avrovulcanxh607/vbit-pi3/vbit3.jpg

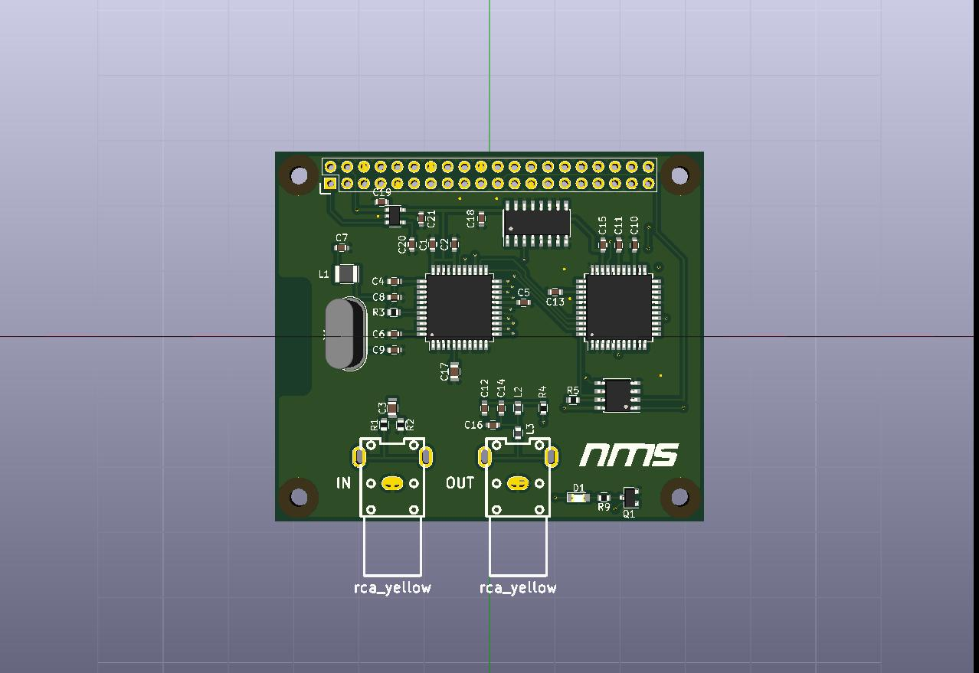
vbit3.jpg
