avrovulcanxh607/vbit-pi3/README.md

# vbit-pi3
Teletext inserter board for the Raspberry Pi

Code available at https://github.com/peterkvt80/vbit-py<br>
Instructions and other details available at https://www.nathanmediaservices.co.uk/vbit-pi/
