avrovulcanxh607/vbit-pi3/vbit3 side2.png

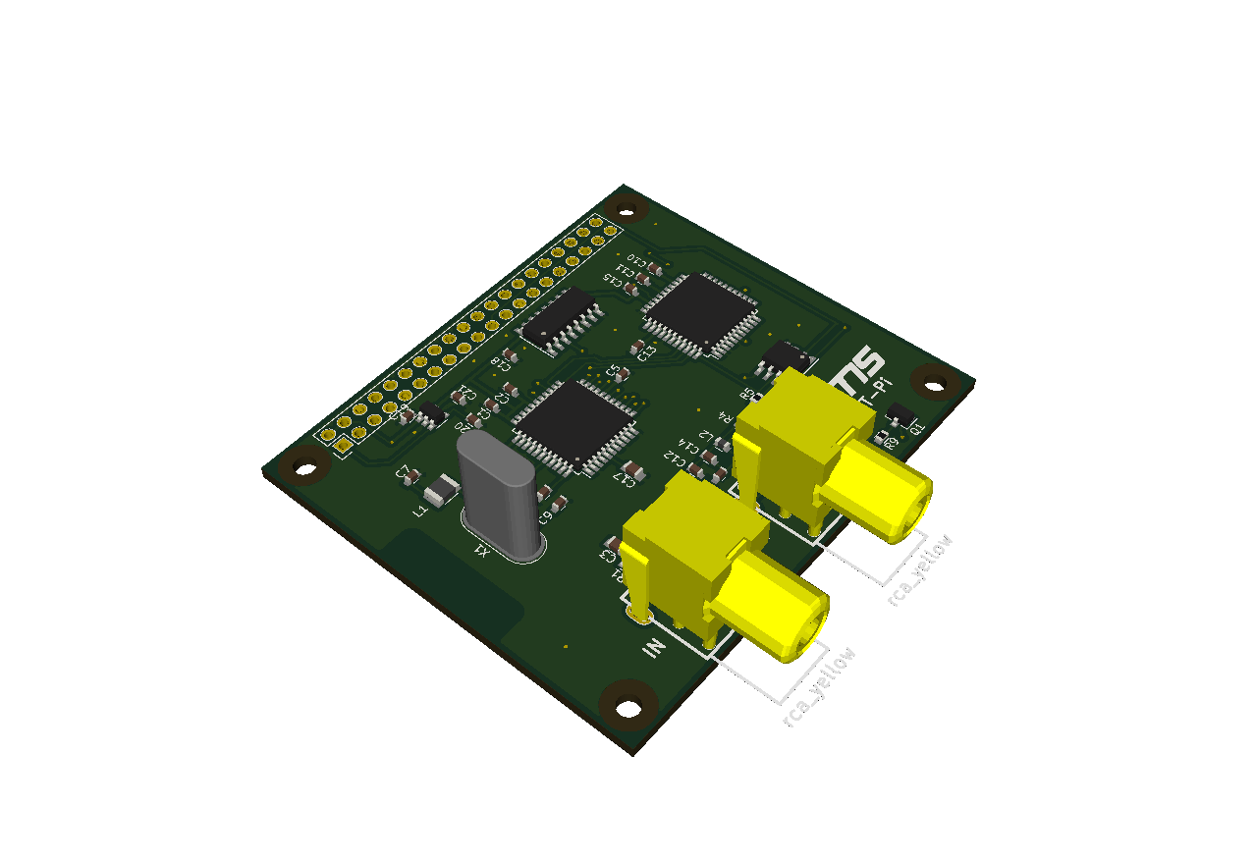
vbit3 side2.png
