avrovulcanxh607/vbit-pi3/vbit3 side.png

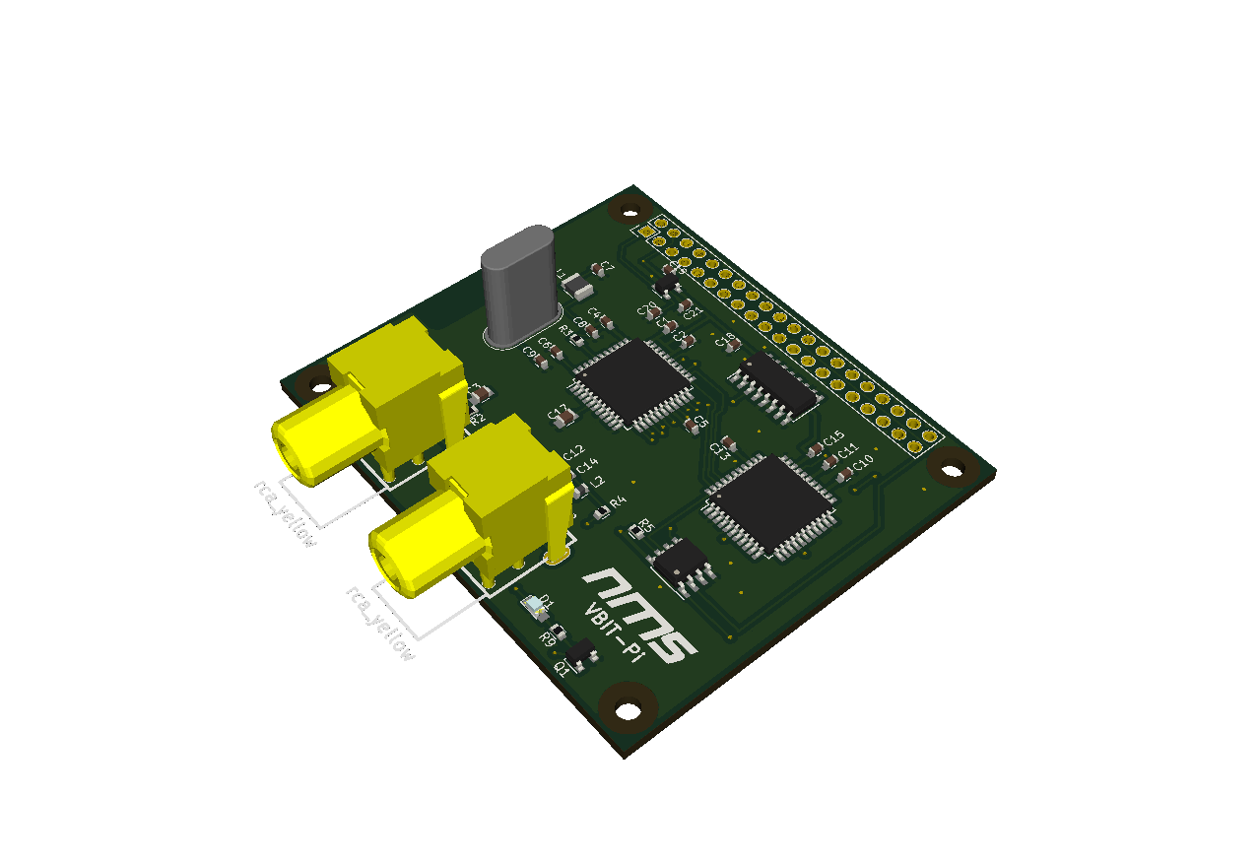
vbit3 side.png
