avrovulcanxh607/vbit-pi3/vbit3.png

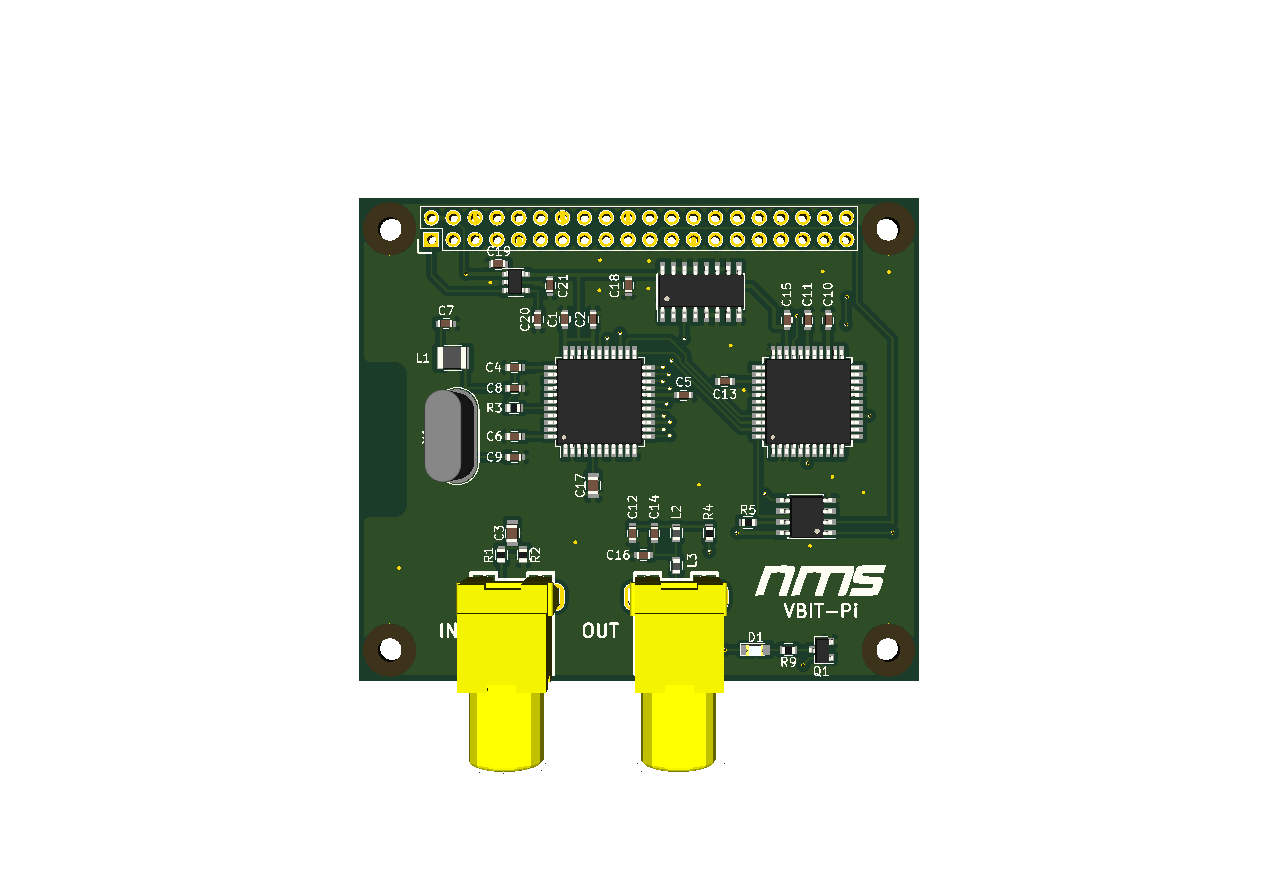
vbit3.png
