avrovulcanxh607/vbit-pi3/vbit-pi2.png

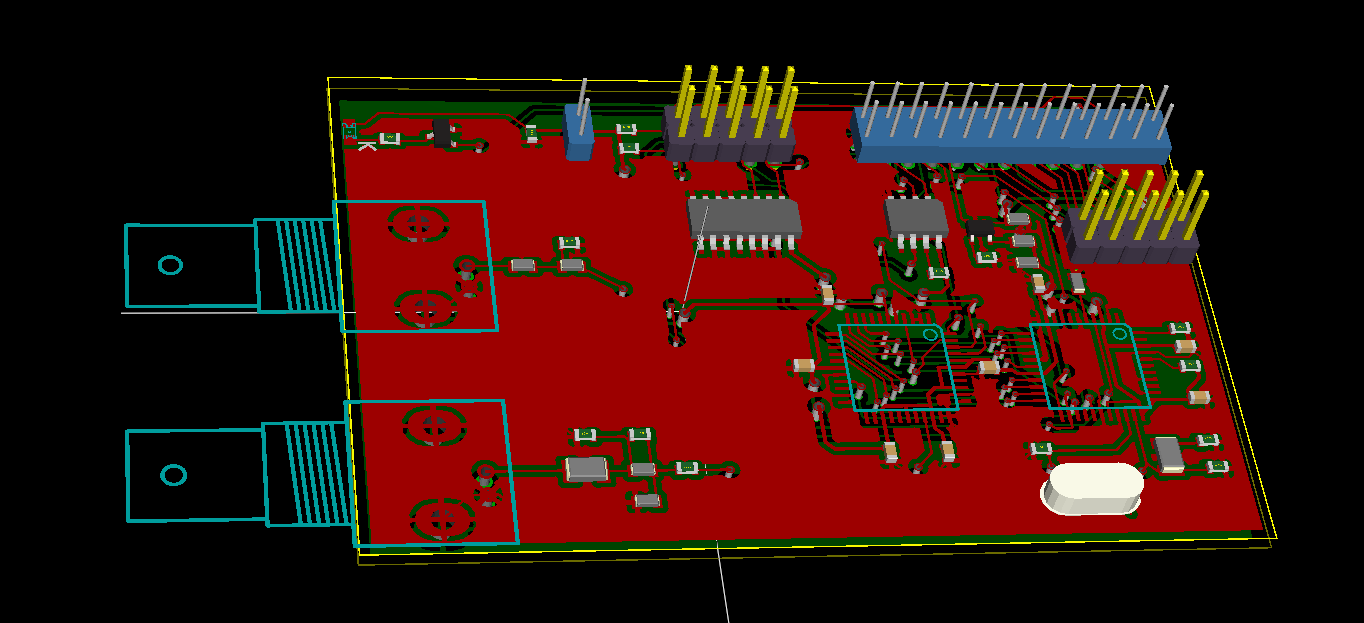
vbit-pi2.png
