avrovulcanxh607/vbit-pi3/vbit3components.xlsx

Information Correct as of 17/03/2019. Some of these components are now obsolete - don't worry, if they can't be found at Farnell they can be bought from UTSource.
QTY= | 10 | VBIT-Pi 3 Kitting List |  |  |  |  | Excess
Description | QTY | Reference | Value | Style | Qty. | Bin | -Short | Supplier | Order Code | Obsolete
PCB | 1 | VBIT-Pi 3 PCB |  |  | 10 | 0 | -10 | JLCPCB
0603 SM CAP | 10 | C1 C2 C4 C5 C10 C11 C13 C15 C18 C22 | 100n | 0603 | 100 | 0 | -100 | FEC | 317287
0603 SM CAP | 3 | C3 C6 C17 | 47n | 0603 | 30 | 0 | -30 | FEC | 1759116
0603 SM CAP | 1 | C7 | 1n | 0603 | 10 | 0 | -10 | FEC | 1759088
0603 SM CAP* | 2 | C8 C9 | 18pF | 0603 | 20 | 0 | -20 | FEC | 1759056
0603 SM CAP | 1 | C12 | 390pF | 0603 | 10 | 0 | -10 | FEC | 1759077
0603 SM CAP | 1 | C14 | 120pF | 0603 | 10 | 0 | -10 | FEC | 1759067
0603 SM CAP | 1 | C16 | 560pF | 0603 | 10 | 0 | -10 | FEC | 1759081
0805 SM CAP | 2 | C19 C21 | 2u2 | 0603 | 20 | 0 | -20 | FEC | 2320817
0603 SM CAP | 1 | C20 | 10n | 0603 | 10 | 0 | -10 | FEC | 2320755
Yellow 0805 LED | 1 | D1 | Yellow | 0805 | 10 | 0 | -10 | FEC | 2099242
0603 SM INDUCTOR | 1 | L1 | 10uH | 0603 | 10 | 0 | -10 | FEC | 2215635
0603 SM INDUCTOR | 2 | L2,L3 | 2u7H | 0603 | 20 | 0 | -20 | FEC | 1669530
Header Socket | 1 | P1 | 20x2 | Pin 20x2 | 10 | 0 | -10 | FEC | 2847248
Right angle PCB RCA socket | 2 | P2 P3 | PSG01547 | RCA | 20 | 0 | -20 | FEC | 1280702
NPN digital Transistor SOT23 | 1 | Q1 | DTC143E | SOT23 | 10 | 0 | -10 | FEC | 8737274
0603 SM RESISTOR | 1 | R1 | 18R | 0603 | 10 | 0 | -10 | FEC | 2447270 (https://uk.farnell.com/multicomp/mcwr06x18r0ftl/res-18r-1-0-1w-thick-film/dp/2447270?st=18r%200603)
0603 SM RESISTOR | 1 | R2 | 56R | 0603 | 10 | 0 | -10 | FEC | 2074286 (https://uk.farnell.com/multicomp/mcsr06x56r0ftl/res-56r-1-0-1w-0603-ceramic/dp/2074286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)
0603 SM RESISTOR | 1 | R3 | 1k | 0603 | 10 | 0 | -10 | FEC | 2073354 (https://uk.farnell.com/multicomp/mcmr06x102-jtl/res-1k-5-0-1w-0603-ceramic/dp/2073354?st=1k%200603%20multicomp)
0603 SM RESISTOR | 1 | R4 | 8R2 | 0603 | 10 | 0 | -10 | FEC | 2845969 (https://uk.farnell.com/multicomp/mc0100w060318r20/res-8r2-1-0-1w-0603-thick-film/dp/2845969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)
0603 SM RESISTOR | 1 | R5 | 47k | 0603 | 10 | 0 | -10 | FEC | 2073510 (https://uk.farnell.com/multicomp/mcmr06x4702ftl/res-47k-1-0-1w-0603-ceramic/dp/2073510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)
0603 SM RESISTOR | 1 | R9 | 220R | 0603 | 10 | 0 | -10 | FEC | 2447298 (https://uk.farnell.com/multicomp/mcwr06x2200ftl/res-220r-1-0-1w-0603-thick-film/dp/2447298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)
SM IC SOT307-2 Video Processor | 1 | U1 | SAA7113 | TQFP44 | 10 | 0 | -10 | UTS |  | *
SM IC SOT23-5 Regulator 3V3 0.5A | 1 | U2 | SP6205 | SOT23-5 | 10 | 0 | -10 | UTS |  | *
SM IC SOT307-2 Video encoder | 1 | U3 | SAA7121 | TQFP44 | 10 | 0 | -10 | UTS |  | *
SM IC Multiplexer | 1 | U4 | 74LVC157 | SOIC16 | 10 | 0 | -10 | FEC | 1103068 | *
SM IC Serial SRAM | 1 | U5 | 23K256-I/SN | SOIC8 | 10 | 0 | -10 | FEC | 1695547
Crystal | 1 | X1 | 24.576MHz/18pF | HC49/S | 10 | 0 | -10 | FEC | 1611790
* Depends on your crystal. Check it's datasheet
