avrovulcanxh607/vbit-pi3/VBIT-Pi Schematic.pdf

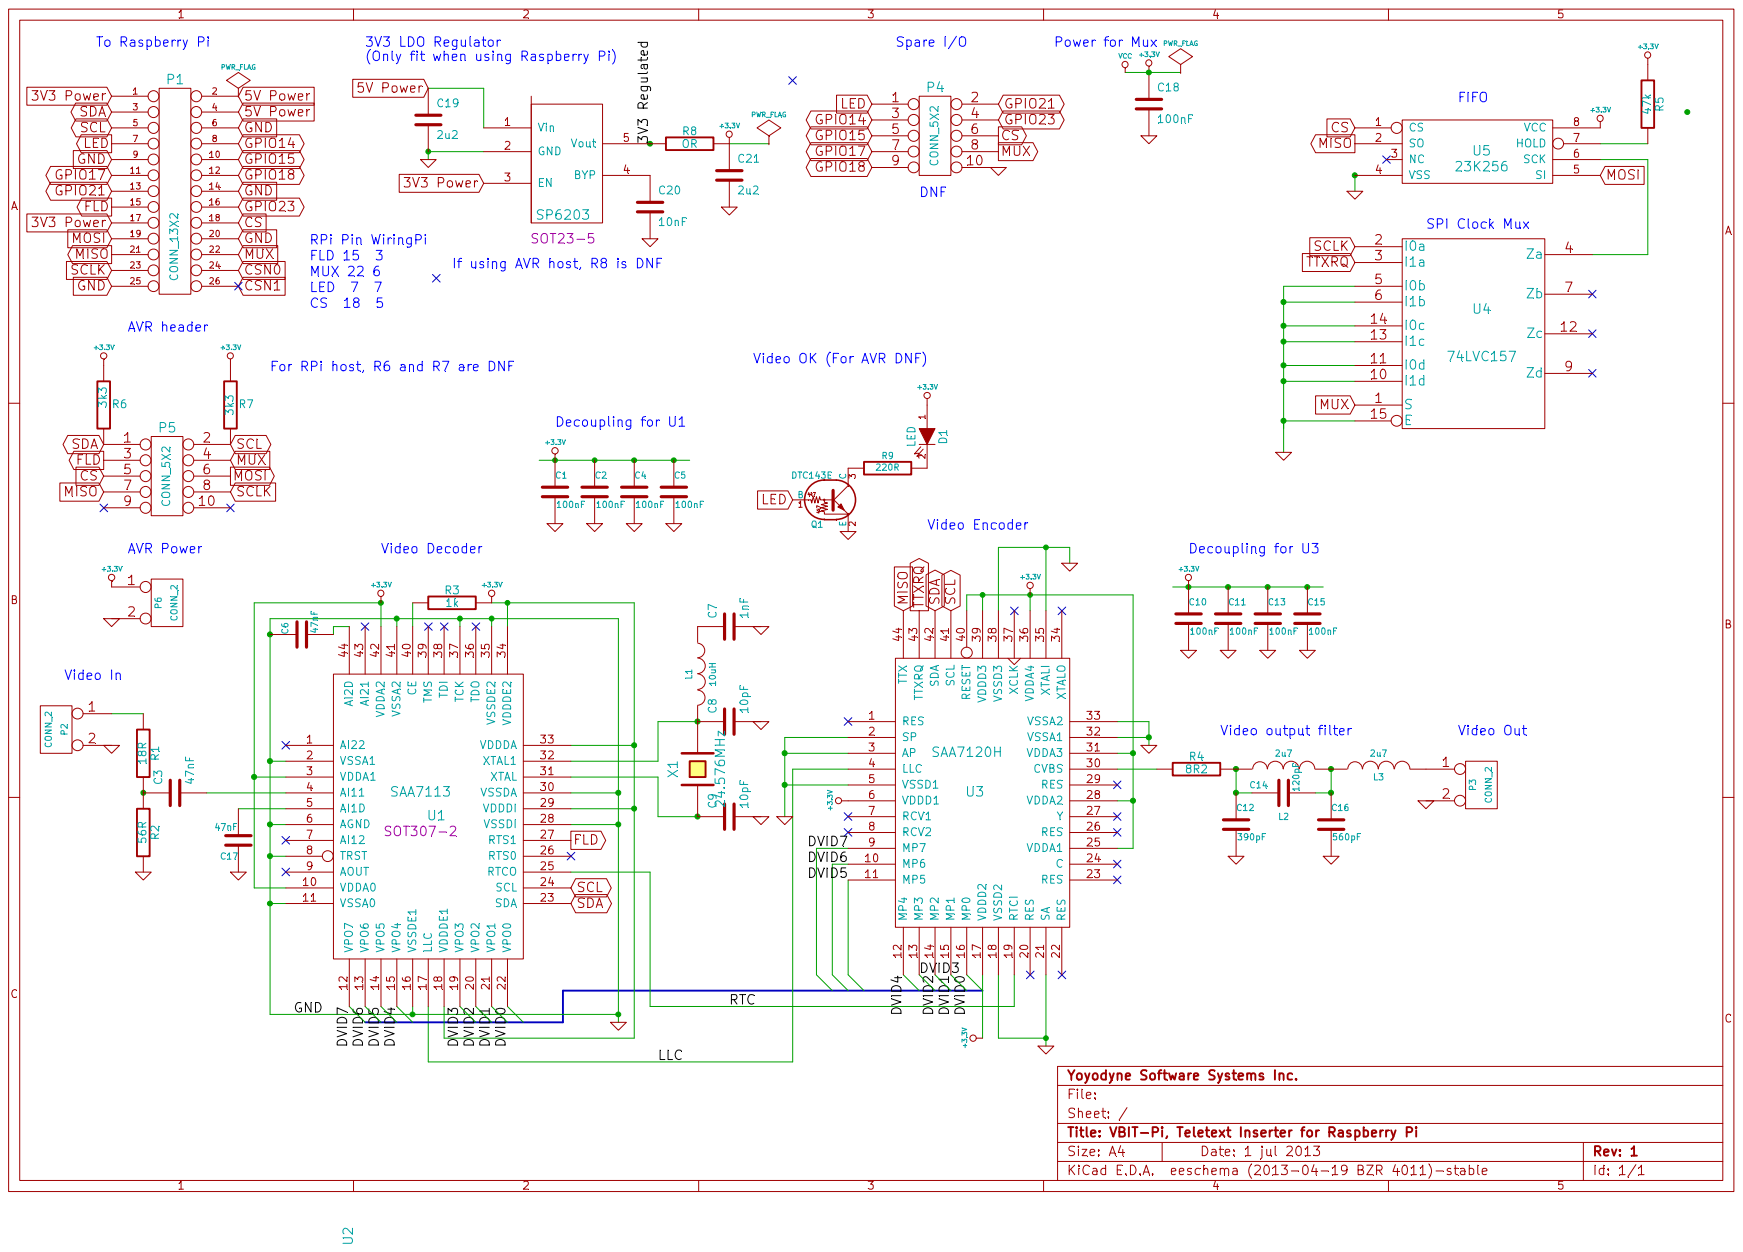
[picture p7: page 1]
