avrovulcanxh607/vbit-pi3/vbit-pi.kicad_pcb

## KiCad design vbit-pi.kicad_pcb (2019-03-16)

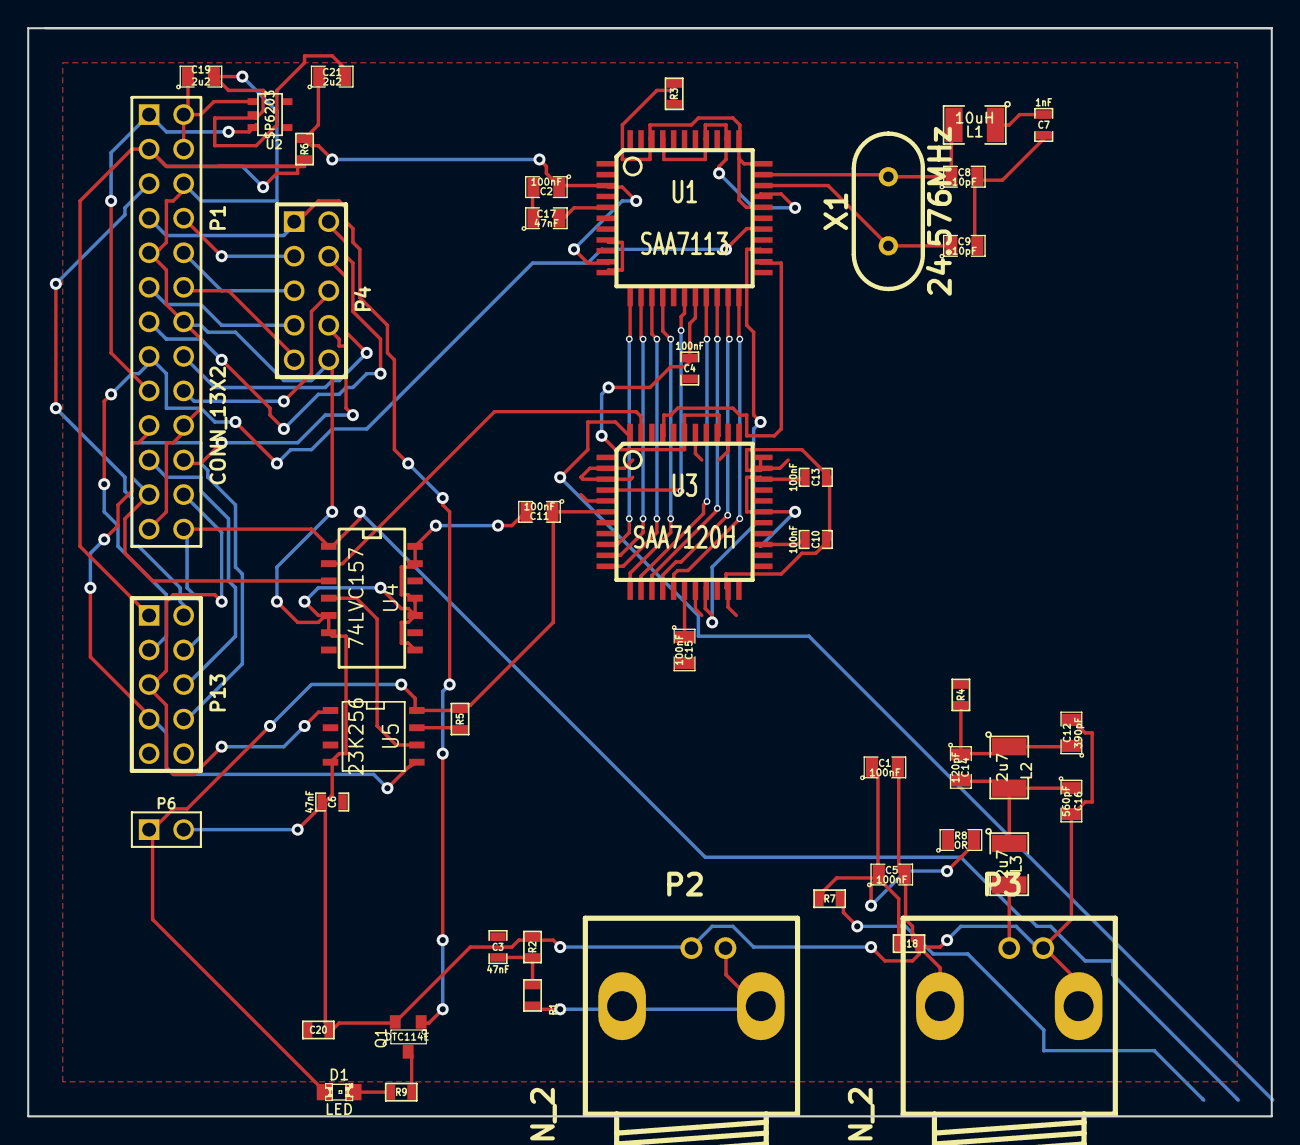
[picture p8: board vbit-pi.kicad_pcb from above]

Board: 2 copper layers, 91.4 x 80.0 mm, 47 parts (0 on the bottom side), 51 nets.

Parts:
C1, C2, C5, C11, C15: 100nF; SM0805
C3, C6: 47nF; SM0603_Capa
C4, C10, C13: 100nF; SM0603_Capa
C7: 1nF; SM0603_Capa
C8, C9: 10pF; SM0805
C12: 390pF; SM0805
C14: 120pF; SM0805
C16: 560pF; SM0805
C17: 47nF; SM0805
C18: 100nF; SM0603
C19, C21: 2u2; SM0805
C20: 10nF; SM0603
D1: LED; LED-0805
L1: 10uH; SM1210
L2, L3: 2u7; SM1210
P1: CONN_13X2; pin_array_13x2
P2, P3: CONN_2; BNC_Socket_TYCO-AMP_RevA_Date21Jun2010
P4, P13: CONN_5X2; PIN_ARRAY_5x2
P6: CONN_2; PIN_ARRAY_2X1
Q1: DTC114E; SOT23
R1: 18R; SM0603
R2: 56R; SM0603
R3: 1k; SM0603
R4: 8R2; SM0603
R5: 47k; SM0603
R6, R7: 3k3; SM0603
R8: OR; SM0805
R9: 220R; SM0603
U1: SAA7113; TQFP44
U2: SP6203; SOT23-5
U3: SAA7120H; TQFP44
U4: 74LVC157; SO14N
U5: 23K256; SO8N
X1: 24.576MHz; HC-49V

Connections:
3V3 Power: P1.1, P1.17, U2.3
5V Power: C19.1, P1.2, P1.4, U2.1
+3.3V: C1.1, C2.1, C4.1, C5.1, C10.1, C11.1, C13.1, C15.1, C18.1, C21.1, D1.1, P6.1, R3.2, R5.1, R6.1, R7.1, R8.2, U1.3, U1.10, U1.18, U1.29, U1.33, U1.34, U1.42, U3.6, U3.17, U3.25, U3.28, U3.31, U3.36, U3.39, U3.40, U5.8
/DVID0: U1.22, U3.16
/DVID1: U1.21, U3.15
/DVID2: U1.20, U3.14
/DVID3: U1.19, U3.13
/DVID4: U1.15, U3.12
/DVID5: U1.14, U3.11
/DVID6: U1.13, U3.10
/DVID7: U1.12, U3.9
/LLC: U1.17, U3.4
/RTC: U1.25, U3.19
CSN: P1.24, P13.5, U5.1
FLD: P1.15, P13.3, U1.27
GND: C1.2, C2.2, C4.2, C5.2, C6.1, C7.2, C8.2, C9.2, C10.2, C11.2, C12.2, C13.2, C15.2, C16.2, C17.1, C18.2, C19.2, C20.2, C21.2, P1.6, P1.9, P1.14, P1.20, P1.25, P2.1, P3.2, P4.10, P6.2, Q1.2, R2.2, U1.2, U1.6, U1.8, U1.11, U1.16, U1.28, U1.30, U1.35, U1.37, U1.41, U2.2, U3.2, U3.3, U3.5, U3.18, U3.21, U3.32, U3.33, U3.35, U3.38, U4.5, U4.6, U4.8, U4.10, U4.11, U4.13, U4.14, U5.4
GPIO4: P1.7, P4.1, Q1.1
GPIO14: P1.8, P4.3
GPIO15: P1.10, P4.5
GPIO17: P1.11, P4.7
GPIO18: P1.12, P4.9
GPIO21: P1.13, P4.2
GPIO23: P1.16, P4.4
GPIO24: P1.18, P4.6
GPIO25: P1.22, P4.8
MISO: P1.21, P13.6, U3.44, U5.2
MOSI: P1.19, P13.7, U5.5
MUX: P1.26, P13.4, U4.1
unnamed: R4.1, U3.30
unnamed: U4.4, U5.6
unnamed: C3.2, U1.4
unnamed: R5.2, U5.7
unnamed: C20.1, U2.4
unnamed: R8.1, U2.5
unnamed: C17.2, U1.5
unnamed: D1.2, R9.2
unnamed: Q1.3, R9.1
unnamed: R3.1, U1.40
unnamed: C9.1, U1.31, X1.1
unnamed: L3.2, P3.1
unnamed: C6.2, U1.44
unnamed: C12.1, C14.1, L2.1, R4.2
unnamed: C14.2, C16.1, L2.2, L3.1
unnamed: C8.1, L1.2, U1.32, X1.2
unnamed: P2.2, R1.1
unnamed: C7.1, L1.1
unnamed: C3.1, R1.2, R2.1
SCL: P1.5, P13.2, R7.2, U1.24, U3.41
SCLK: P1.23, P13.8, U4.3
SDA: P1.3, P13.1, R6.2, U1.23, U3.42
TTXRQ: U3.43, U4.2
