avrovulcanxh607/vbit-pi3/(threads)

Thread 2 (2024-05-27):

Up to date schematic file missing

deveon95, 2024-05-27:
Is the schematic file that corresponds to [vbit3.kicad_pcb](https://github.com/avrovulcanxh607/vbit-pi3/blob/master/vbit3.kicad_pcb) available or were the changes like the 40-way connector just transplanted into the PCB file without ever updating the schematic?

avrovulcanxh607, 2024-05-27:
I honestly don't remember - but having taken a look through my archives I can't find any improved version, so I assume it was just transplanted in place yeah.

deveon95, 2024-05-27:
OK, I'll see if I can get it to match up at some point.

There are other differences such as the removal of everything to do with the AVR, so if it proves tricky to do, I might just go for the easy option of sticking in the ferrite for AVDD on U1 as discussed on Discord directly in the PCB file.

Closed 2024-05-28.
