avrovulcanxh607/vbit-pi3/(commit log)

2019-03-17 fixed old order codes
    [vbit3components.xlsx]
2019-06-03 Made some design for manufacturability layout improvements, changed some footprints and updated BOM
    [vbit3.kicad_pcb, vbit3components.xlsx]
